chiabrian/hexbug/Firmware/README.md

## Example Summary

Empty project using DriverLib.
This example shows a basic empty project using DriverLib with just main file
and SysConfig initialization.

## Peripherals & Pin Assignments

| Peripheral | Pin | Function |
| --- | --- | --- |
| SYSCTL |  |  |
| DEBUGSS | PA20 | Debug Clock |
| DEBUGSS | PA19 | Debug Data In Out |

## BoosterPacks, Board Resources & Jumper Settings

Visit [LP_MSPM0L1306](https://www.ti.com/tool/LP-MSPM0L1306) for LaunchPad information, including user guide and hardware files.

| Pin | Peripheral | Function | LaunchPad Pin | LaunchPad Settings |
| --- | --- | --- | --- | --- |
| PA20 | DEBUGSS | SWCLK | J2_13 | <ul><li>PA20 is used by SWD during debugging<br><ul><li>`J101 15:16 ON` Connect to XDS-110 SWCLK while debugging<br><li>`J101 15:16 OFF` Disconnect from XDS-110 SWCLK if using pin in application</ul></ul> |
| PA19 | DEBUGSS | SWDIO | J2_17 | <ul><li>PA19 is used by SWD during debugging<br><ul><li>`J101 13:14 ON` Connect to XDS-110 SWDIO while debugging<br><li>`J101 13:14 OFF` Disconnect from XDS-110 SWDIO if using pin in application</ul></ul> |

### Device Migration Recommendations
This project was developed for a superset device included in the LP_MSPM0L1306 LaunchPad. Please
visit the [CCS User's Guide](https://software-dl.ti.com/msp430/esd/MSPM0-SDK/latest/docs/english/tools/ccs_ide_guide/doc_guide/doc_guide-srcs/ccs_ide_guide.html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)
for information about migrating to other MSPM0 devices.

### Low-Power Recommendations
TI recommends to terminate unused pins by setting the corresponding functions to
GPIO and configure the pins to output low or input with internal
pullup/pulldown resistor.

SysConfig allows developers to easily configure unused pins by selecting **Board**→**Configure Unused Pins**.

For more information about jumper configuration to achieve low-power using the
MSPM0 LaunchPad, please visit the [LP-MSPM0L1306 User's Guide](https://www.ti.com/lit/slau869).

## Example Usage

Compile, load and run the example.
