chiabrian/hexbug/hexbug_remote/hexbug_remote.step

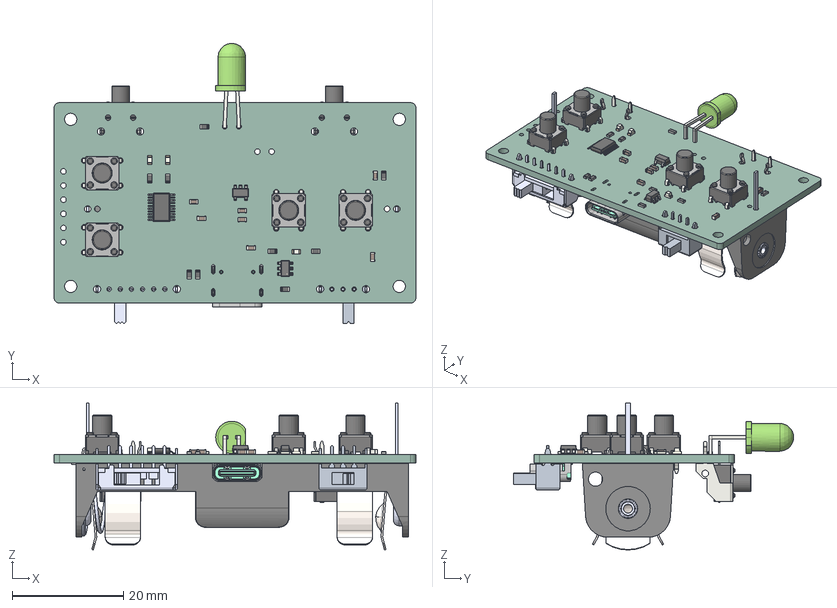
[picture p1: CAD file, 2026-03-07]
hexbug_remote/hexbug_remote.step
65.0 x 50.4 x 26.4 mm
R_0603_1608Metric x 9
SW_TH_Tactile_Omron_B3F-106x x 4
LED_D5.0mm_Horizontal_O6.35mm_Z3.0mm
SOT-23-6
C_0603_1608Metric x 7
LED_0603_1608Metric x 3
SOT-23-5
BODY-VSSOP
LEAD-VSSOP x 20
Battery_MPD_BCAAPC
Amphenol_12402012E212A
keystone-PN53 x 2
SW_Tactile_SPST_Angled_PTS645Vx58-2LFS x 2
SK-12D07-VG 4 NS PA_PART1
Same_Sky_SLW-147844-4A-RA-S-D
hexbug_remote_PCB
