chiabrian/hexbug/mechanical/Enclosure.FCStd

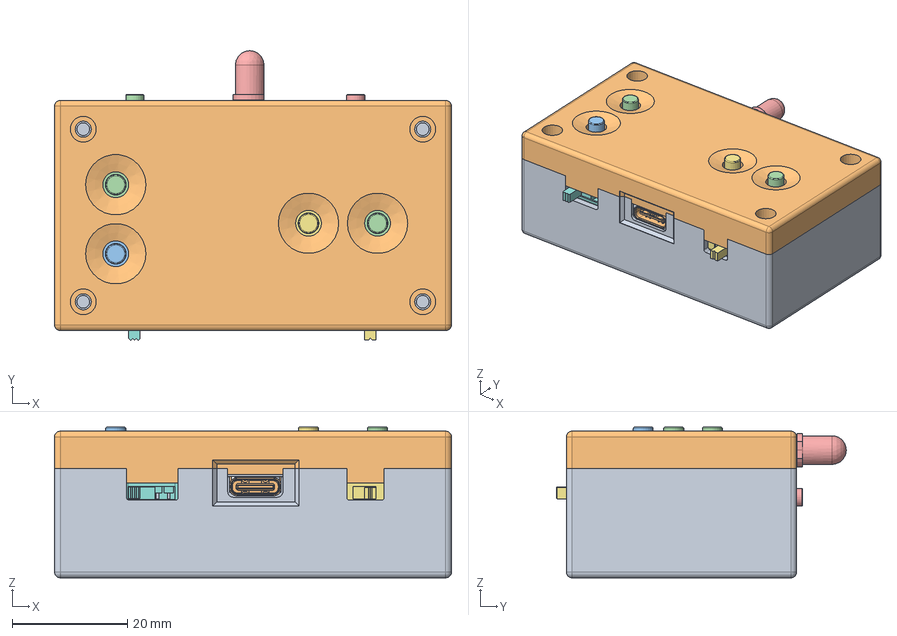
[picture p2: CAD file, 2026-03-07]
mechanical/Enclosure.FCStd
69.0 x 50.4 x 26.2 mm
BaseBody
CoverBody
R_0603_1608Metric
SW_TH_Tactile_Omron_B3F-106x
LED_D5.0mm_Horizontal_O6.35mm_Z3.0mm
SOT-23-6
SW_TH_Tactile_Omron_B3F-106x001
R_0603_1608Metric001
C_0603_1608Metric
C_0603_1608Metric001
SW_TH_Tactile_Omron_B3F-106x002
SW_TH_Tactile_Omron_B3F-106x003
R_0603_1608Metric002
LED_0603_1608Metric
C_0603_1608Metric002
R_0603_1608Metric003
C_0603_1608Metric003
R_0603_1608Metric004
SOT-23-5
R_0603_1608Metric005
R_0603_1608Metric006
R_0603_1608Metric007
R_0603_1608Metric016
C_0603_1608Metric004
BODY-VSSOP
LEAD-VSSOP
LEAD-VSSOP001
LEAD-VSSOP002
LEAD-VSSOP003
LEAD-VSSOP004
LEAD-VSSOP005
LEAD-VSSOP006
LEAD-VSSOP007
LEAD-VSSOP008
LEAD-VSSOP009
LEAD-VSSOP010
LEAD-VSSOP011
LEAD-VSSOP012
LEAD-VSSOP013
LEAD-VSSOP014
LEAD-VSSOP015
LEAD-VSSOP016
LEAD-VSSOP017
LEAD-VSSOP018
LEAD-VSSOP019
C_0603_1608Metric005
C_0603_1608Metric012
LED_0603_1608Metric001
LED_0603_1608Metric002
Amphenol_12402012E212A
keystone-PN53
SW_Tactile_SPST_Angled_PTS645Vx58-2LFS
SW_Tactile_SPST_Angled_PTS645Vx58-2LFS001
keystone-PN054
SK-12D07-VG 4 NS PA_PART002
Same_Sky_SLW-147844-4A-RA-S-D
hexbug_remote_PCB
