chiabrian/hexbug/mechanical/Enclosure-Cover.step

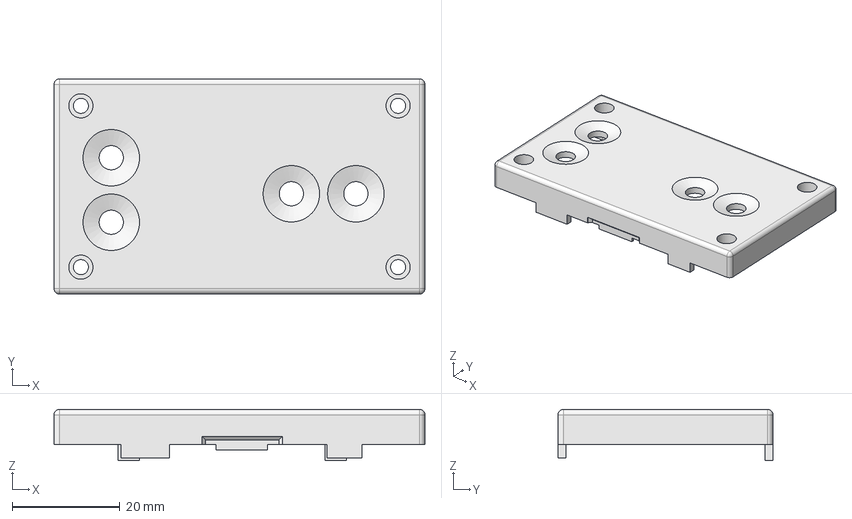
[picture p3: CAD file, 2026-03-07]
mechanical/Enclosure-Cover.step
69.0 x 40.0 x 9.50 mm
