chiabrian/hexbug/mechanical/Enclosure-Base.step

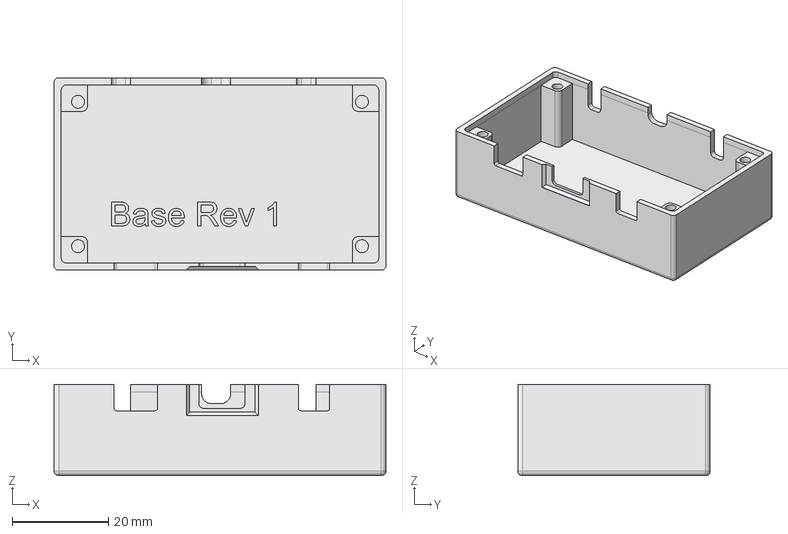
[picture p4: CAD file, 2026-03-07]
mechanical/Enclosure-Base.step
69.0 x 40.0 x 19.0 mm
