chiabrian/hexbug/hexbug_remote/hexbug_remote.kicad_pcb

## KiCad design hexbug_remote/hexbug_remote.kicad_pcb (2026-04-17)

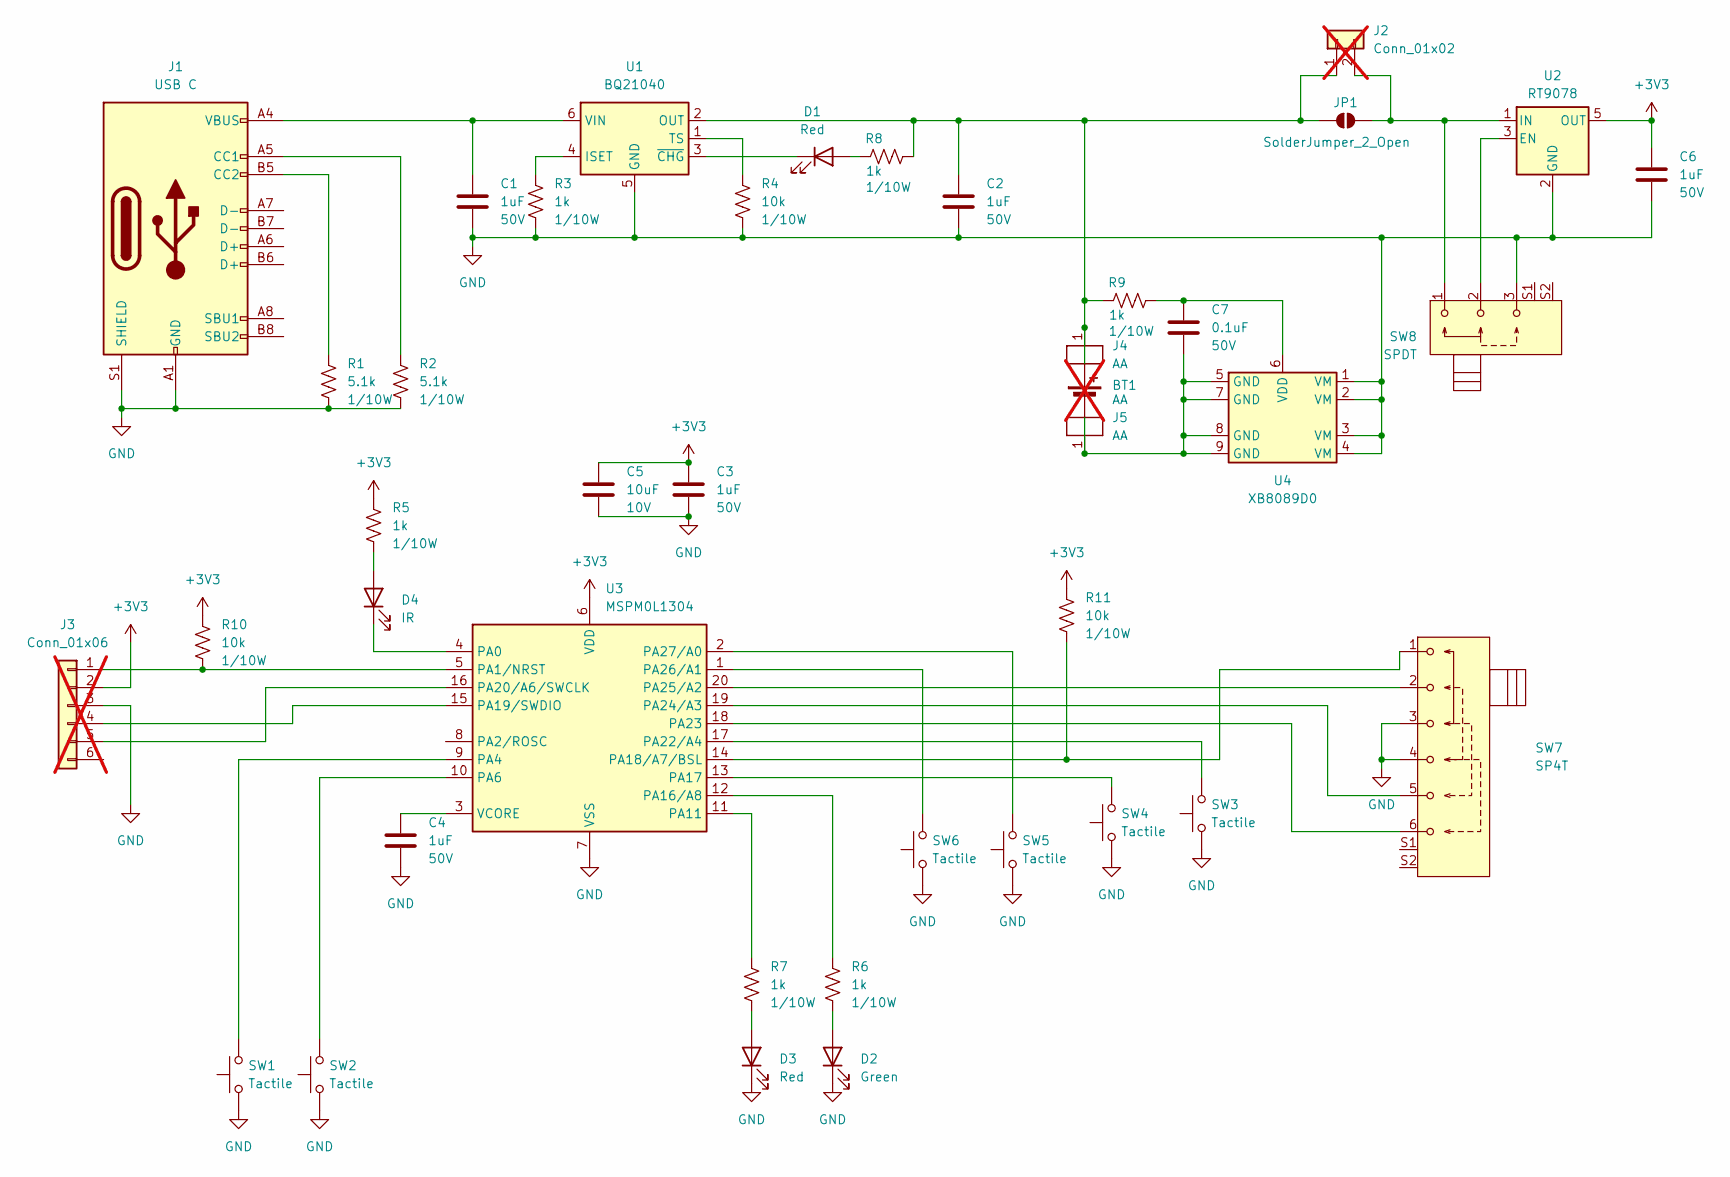
[picture p5: schematic hexbug_remote.kicad_sch]

Parts:
BT1: AA; Battery_Holder_MPD_BCAAPC; Manufacturer Part Numbe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 2460; LCSC Part Number C5370863; not fitted
C1, C2, C3, C4, C6: 1uF; C_0603_1608Metric; Voltage 50V; Tolerance 10%; Manufacturer Part Numbe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 CL10A105KB8NNNC; LCSC Part Number C15849
C5: 10uF; C_0603_1608Metric; Voltage 10V; Tolerance 10%; Manufacturer Part Numbe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 CL10A106KP8NNNC; LCSC Part Number C19702
C7: 0.1uF; C_0603_1608Metric; Voltage 50V; Tolerance 10%; Manufacturer Part Numbe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 CL10B104KB8NNNC; LCSC Part Number C14663
D1, D3: Red; LED_0603_1608Metric_Pad1.05x0.95mm_HandSolder; Manufacturer Part Numbe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 KT-0603R; LCSC Part Number C2286
D2: Green; LED_0603_1608Metric_Pad1.05x0.95mm_HandSolder; Manufacturer Part Numbe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 KT-0603G; LCSC Part Number C12624
D4: IR; LED_D5.0mm_Horizontal_O6.35mm_Z3.0mm; Manufacturer Part Numbe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 IR333C-A; LCSC Part Number C5130
J1: USB C; USBC_16P; Voltage 20V; Manufacturer Part Numbe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 HC-TYPE-C-16P-01A; LCSC Part Number C2894897
J2: Conn_01x02; PinHeader_1x02_P2.54mm_Vertical; not fitted
J3: Conn_01x06; PinHeader_1x06_P2.54mm_Vertical; not fitted
J4, J5: AA; Battery_Clip_Keystone_53; Manufacturer Part Numbe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 53; LCSC Part Number C5352788
JP1: SolderJumper_2_Open; SolderJumper-2_P1.3mm_Open_TrianglePad1.0x1.5mm
R1, R2: 5.1k; R_0603_1608Metric_Pad0.98x0.95mm_HandSolder; Tolerance 1%; Manufacturer Part Numbe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 RC0603FR-075K1L; LCSC Part Number C23186
R3, R5, R6, R7, R8, R9: 1k; R_0603_1608Metric_Pad0.98x0.95mm_HandSolder; Tolerance 1%; Manufacturer Part Numbe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 RC0603FR-071KL; LCSC Part Number C21190
R4, R10, R11: 10k; R_0603_1608Metric_Pad0.98x0.95mm_HandSolder; Tolerance 1%; Manufacturer Part Numbe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 RC0603FR-0710KL; LCSC Part Number C25804
SW1, SW2: Tactile; SW_Tactile_SPST_Angled_PTS645Vx58-2LFS; Voltage 12V; Manufacturer Part Numbe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 TC-6615-7-260G; LCSC Part Number C2845275
SW3, SW4, SW5, SW6: Tactile; SW_TH_Tactile_Omron_B3F-106x; Voltage 12V; Manufacturer Part Numbe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 TC-6610-7-260G; LCSC Part Number C2845253
SW7: SP4T; SW_SP4T_Slide_Samesky_SLW-147844; Voltage 50V; Manufacturer Part Numbe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 SK14D07VG4; LCSC Part Number C22435626
SW8: SPDT; SW_SPDT_Slide_CK_SK12D07VG4; Voltage 30V; Manufacturer Part Numbe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 SK12D07VG4; LCSC Part Number C22435621
U1: BQ21040; SOT-23-6; Voltage 3.5-28V; Manufacturer Part Numbe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 BQ21040DBVR; LCSC Part Number C202311
U2: RT9078; SOT-23-5; Voltage 1.2-5.5V; Manufacturer Part Numbe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 RT9078-33GJ5; LCSC Part Number C110427
U3: MSPM0L1304; TI_DGS20; Voltage 1.62-3.6V; Manufacturer Part Numbe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 MSPM0L1304TDGS20R; LCSC Part Number C22362611
U4: XB8089D0; SOP-8-1EP_3.9x4.9mm_P1.27mm_EP2.4x3.3mm; Voltage 6V; Manufacturer Part Numbe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 XB8089D0; LCSC Part Number C2760005

Connections:
+3V3: C3.1, C5.1, C6.1, J3.2, R5.1, R10.1, R11.1, U2.5 (OUT), U3.6 (VDD)
GND: C1.2, C2.2, C3.2, C4.2, C5.2, C6.2, D2.1 (K), D3.1 (K), J1.A1 (GND), J1.A12 (GND), J1.B1 (GND), J1.B12 (GND), J1.S1 (SHIELD), J3.3, R1.2, R2.2, R3.2, R4.2, SW1.1, SW2.1, SW3.1, SW4.1, SW5.1, SW6.1, SW7.3, SW7.4, SW8.3, U1.5 (GND), U2.2 (GND), U3.7 (VSS), U4.1 (VM), U4.2 (VM), U4.3 (VM), U4.4 (VM)
unnamed: BT1.1 (+), C2.1, J2.1, J4.1, JP1.1 (A), R8.1, R9.2, U1.2 (OUT)
unnamed: BT1.2 (-), C7.2, J5.1, U4.5 (GND), U4.7 (GND), U4.8 (GND), U4.9 (GND)
unnamed: D1.2 (A), R8.2
unnamed: D1.1 (K), U1.3 (~CHG)
unnamed: D2.2 (A), R6.2
unnamed: D3.2 (A), R7.2
unnamed: D4.2 (A), R5.2
unnamed: D4.1 (K), U3.4 (PA0)
unnamed: J1.A5 (CC1), R2.1
unnamed: J1.B5 (CC2), R1.1
unnamed: J2.2, JP1.2 (B), SW8.1, U2.1 (IN)
unnamed: J3.1, R10.2, U3.5 (PA1/NRST)
unnamed: J3.4, U3.15 (PA19/SWDIO)
unnamed: J3.5, U3.16 (PA20/A6/SWCLK)
unnamed: R3.1, U1.4 (ISET)
unnamed: R4.1, U1.1 (TS)
unnamed: C1.1, J1.A4 (VBUS), J1.A9 (VBUS), J1.B4 (VBUS), J1.B9 (VBUS), U1.6 (VIN)
unnamed: SW8.2, U2.3 (EN)
unnamed: SW1.2, U3.9 (PA4)
unnamed: SW2.2, U3.10 (PA6)
unnamed: R7.1, U3.11 (PA11)
unnamed: R6.1, U3.12 (PA16/A8)
unnamed: SW4.2, U3.13 (PA17)
unnamed: R11.2, SW7.1, U3.14 (PA18/A7/BSL)
unnamed: SW3.2, U3.17 (PA22/A4)
unnamed: SW7.6, U3.18 (PA23)
unnamed: SW7.5, U3.19 (PA24/A3)
unnamed: SW7.2, U3.20 (PA25/A2)
unnamed: SW6.2, U3.1 (PA26/A1)
unnamed: SW5.2, U3.2 (PA27/A0)
unnamed: C4.1, U3.3 (VCORE)
unnamed: C7.1, R9.1, U4.6 (VDD)

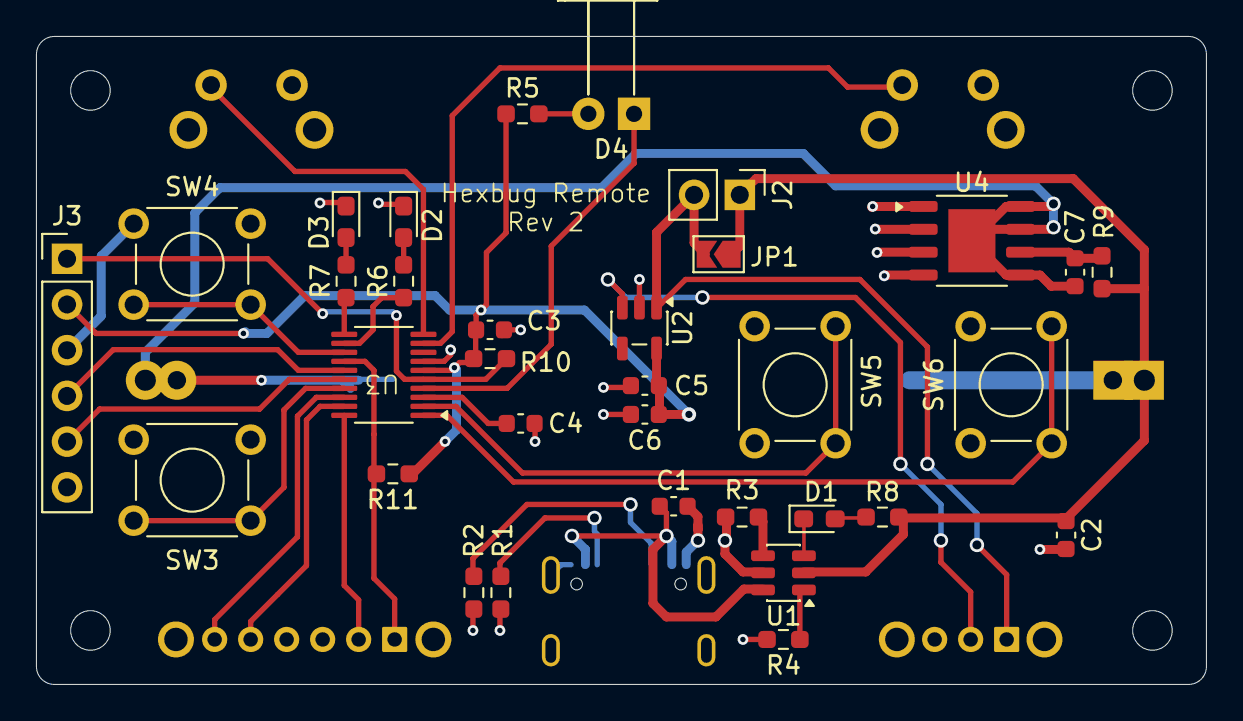
[picture p6: board hexbug_remote.kicad_pcb from above]

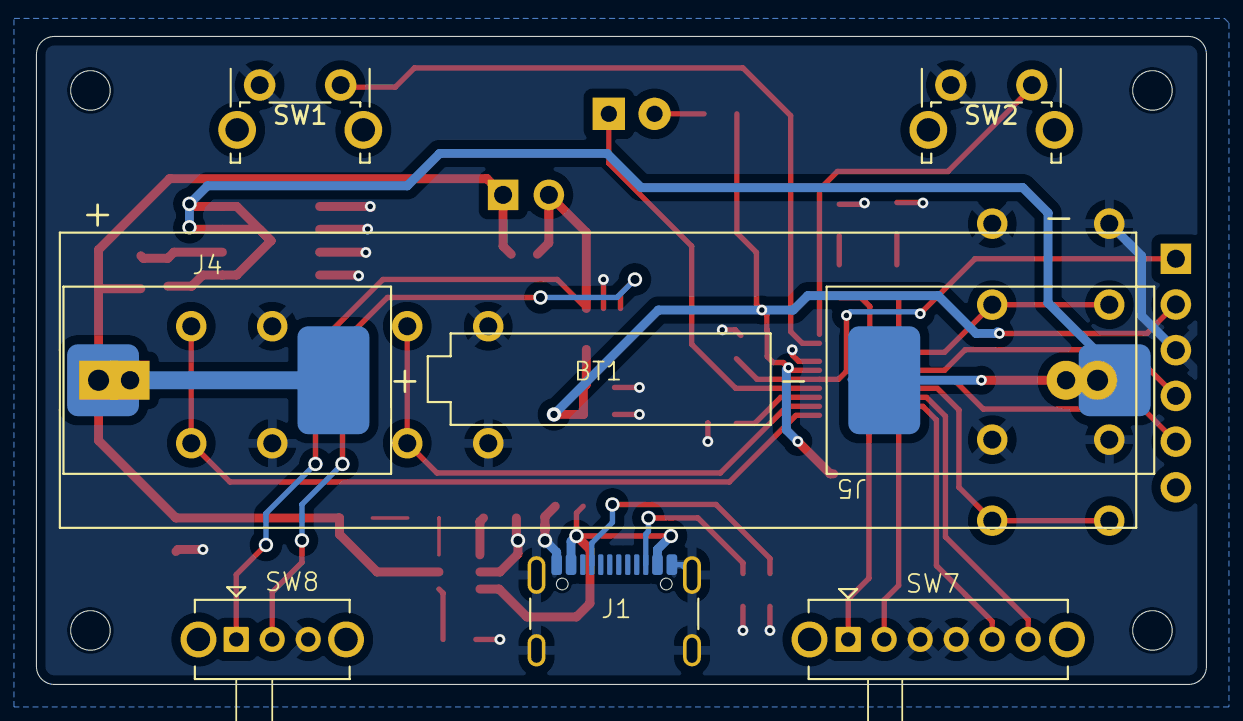
[picture p7: board hexbug_remote.kicad_pcb from below]

Board: 2 copper layers, 65.0 x 36.0 mm, 41 parts (8 on the bottom side), 34 nets.
