chiabrian/hexbug/(commit log)

2026-02-24 Update Enclosure
    [Enclosure-Base.step, Enclosure-Cover.step, Enclosure.FCStd]
2026-03-01 Update to use local db lib
    [hexbug_remote.kicad_sch]
2026-03-01 Update Libraries
    [hexbug_remote.kicad_sch]
2026-03-02 --Add Gerber Files
    [hexbug_remote-B_Cu.gbr, hexbug_remote-B_Mask.gbr, hexbug_remote-B_Paste.gbr, hexbug_remote-B_Silkscreen.gbr, hexbug_remote-Edge_Cuts.gbr, hexbug_remote-F_Cu.gbr, hexbug_remote-F_Mask.gbr, hexbug_remote-F_Paste.gbr]
2026-03-07 Add Battery Protection
    [Enclosure-Base.step, Enclosure-Cover.step, Enclosure.FCStd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]
2026-03-07 Update Step File
    [hexbug_remote.csv, hexbug_remote.kicad_sch, hexbug_remote.step]
2026-03-07 Increase depth for battery clips
    [Enclosure-Base.step, Enclosure-Cover.step, Enclosure.FCStd]
2026-03-29 Fix Schematic Symbol
    [hexbug_remote.kicad_sch]
2026-04-17 Add Firmware Update PCB to Rev 2 --Pull up resistor for reset
    [hexbug_remote.kicad_pcb, hexbug_remote.kicad_sch]
